jakubprzybytek/ActiveLoad/STM32CubeIDE/ActiveLoadBigMosfets/TouchGFX/generated/fonts/UnicodeListliquidcrystal_20_4.txt

2
32
45
46
48
49
50
51
52
53
54
55
56
57
58
63
65
77
80
102
111
