jakubprzybytek/ActiveLoad/modalBackground.png

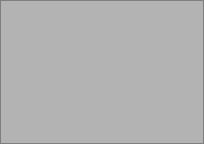
modalBackground.png
