jakubprzybytek/ActiveLoad/Fusion360/pec11r-4x15k-sxxxx.stp

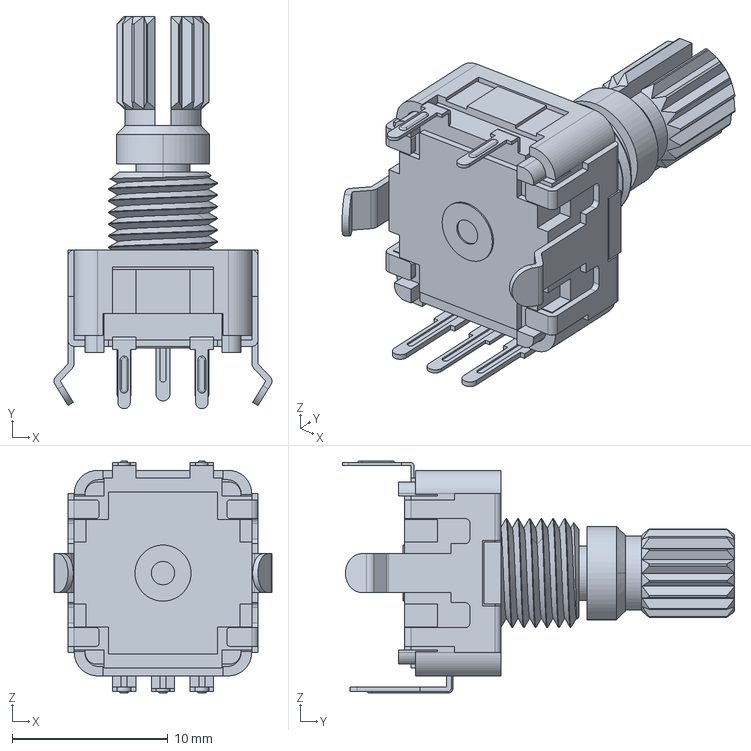
[picture p2: CAD file, 2020-04-10]
Fusion360/pec11r-4x15k-sxxxx.stp
14.0 x 25.2 x 14.9 mm
