jakubprzybytek/ActiveLoad/KiCad/ActiveLoadBigMosfets/ActiveLoadBigMosfets.kicad_pcb

## KiCad design KiCad/ActiveLoadBigMosfets/ActiveLoadBigMosfets.kicad_pcb (2020-07-11)

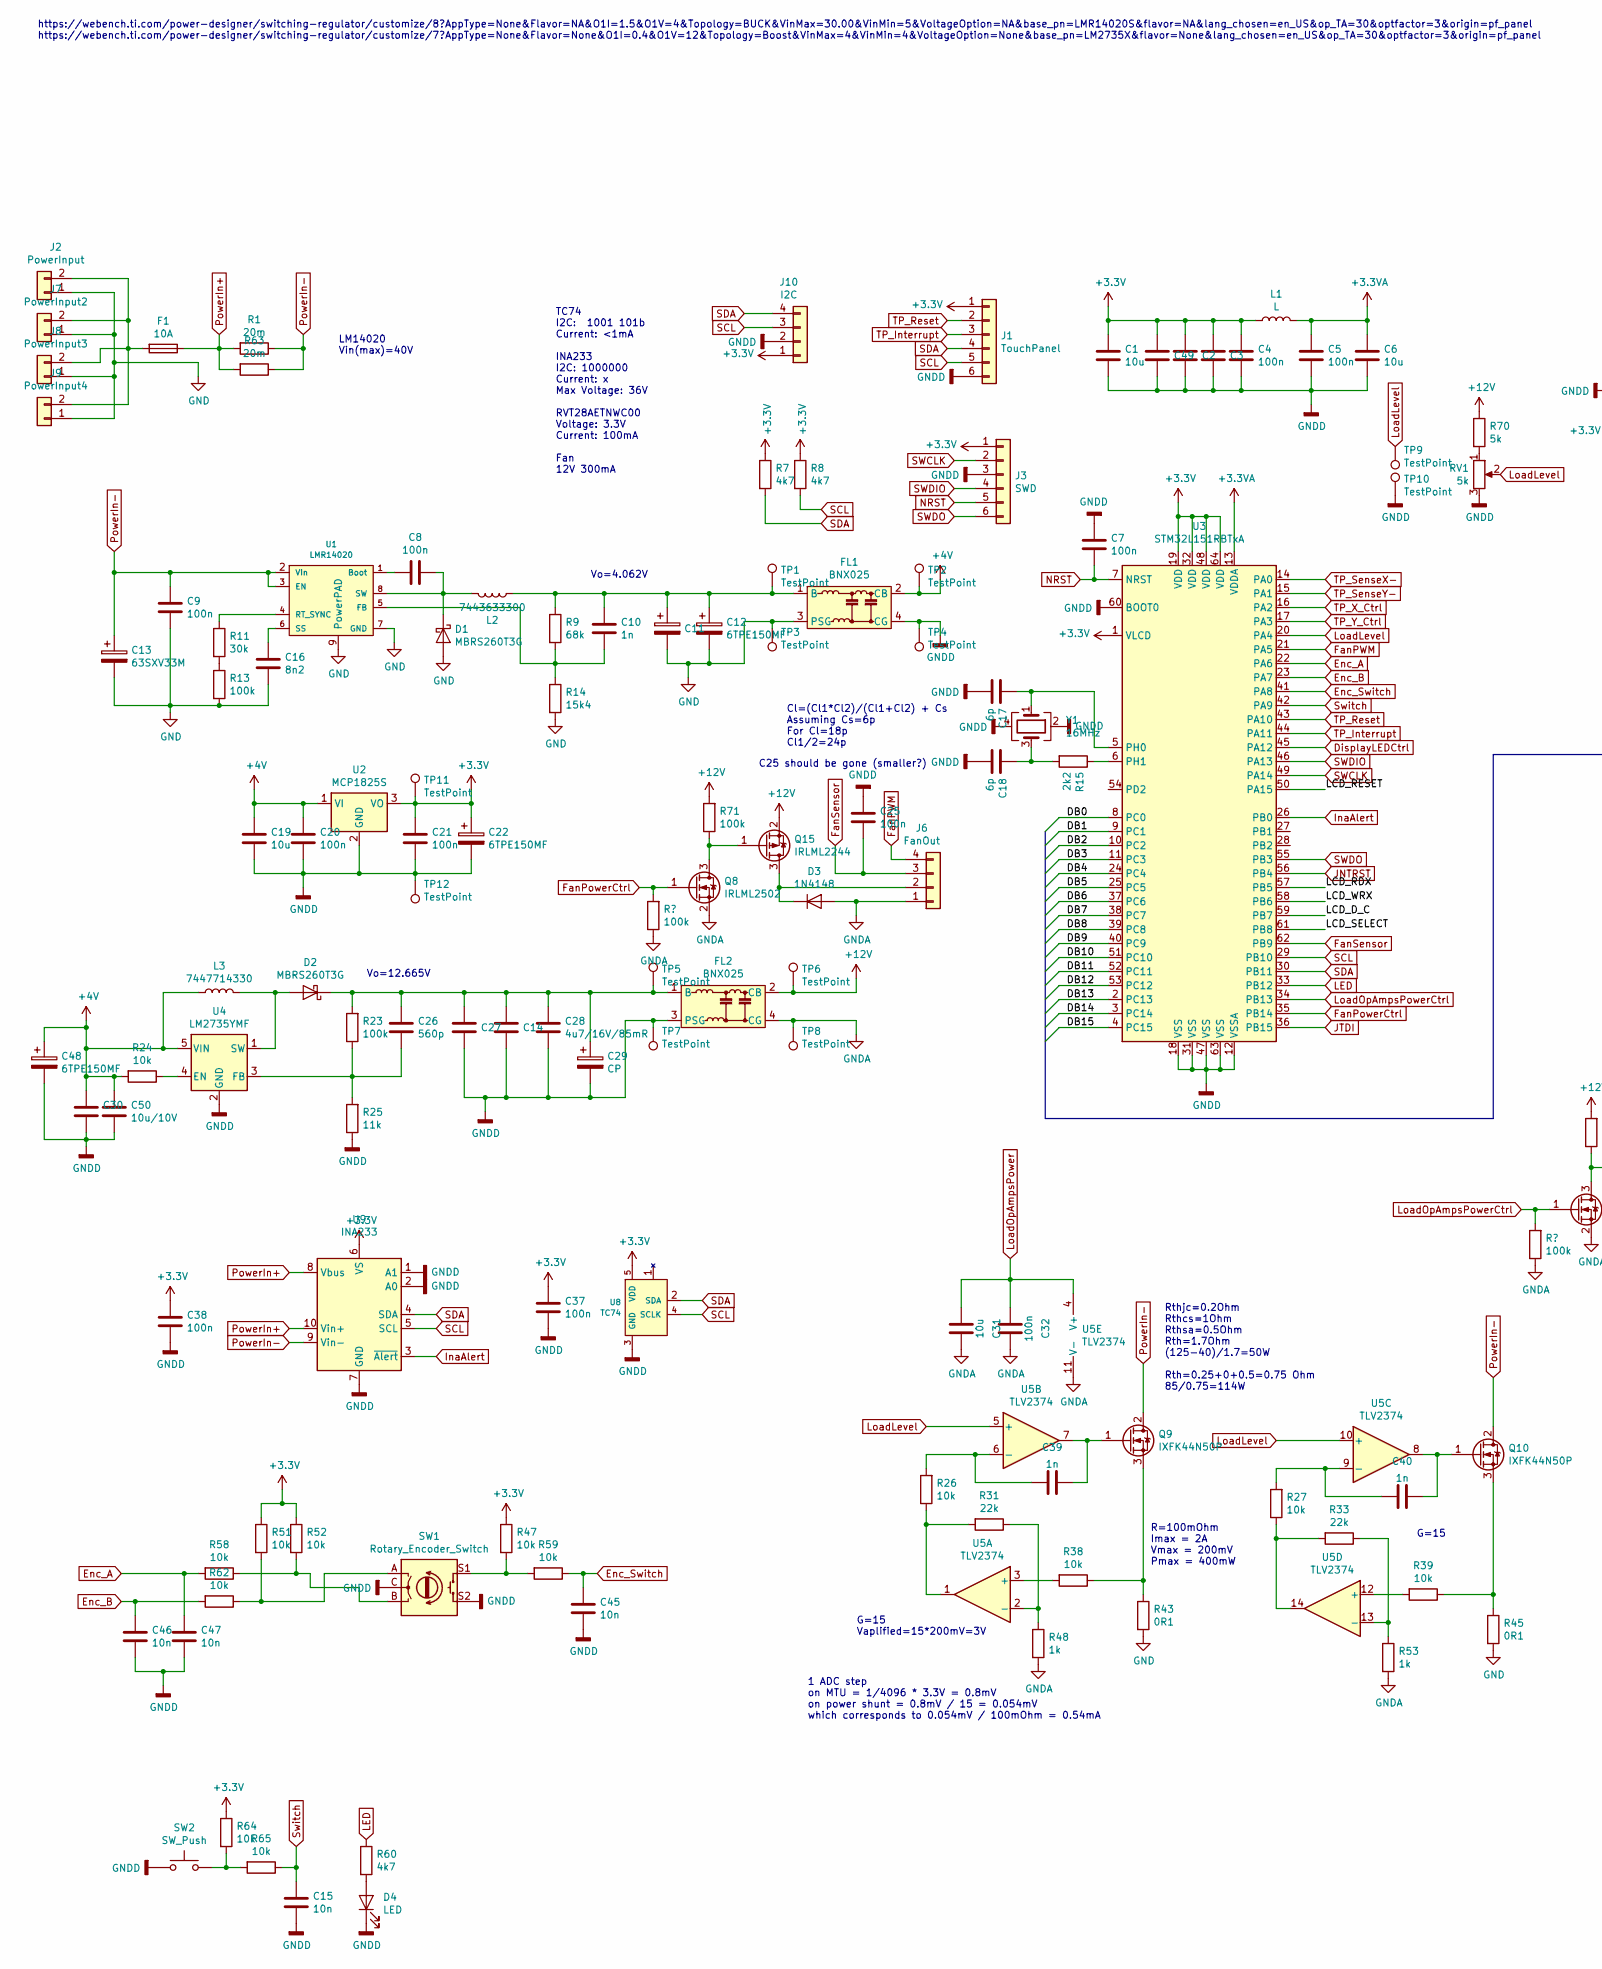
[picture p3: schematic ActiveLoadBigMosfets.sch, part in row 1, column 1]

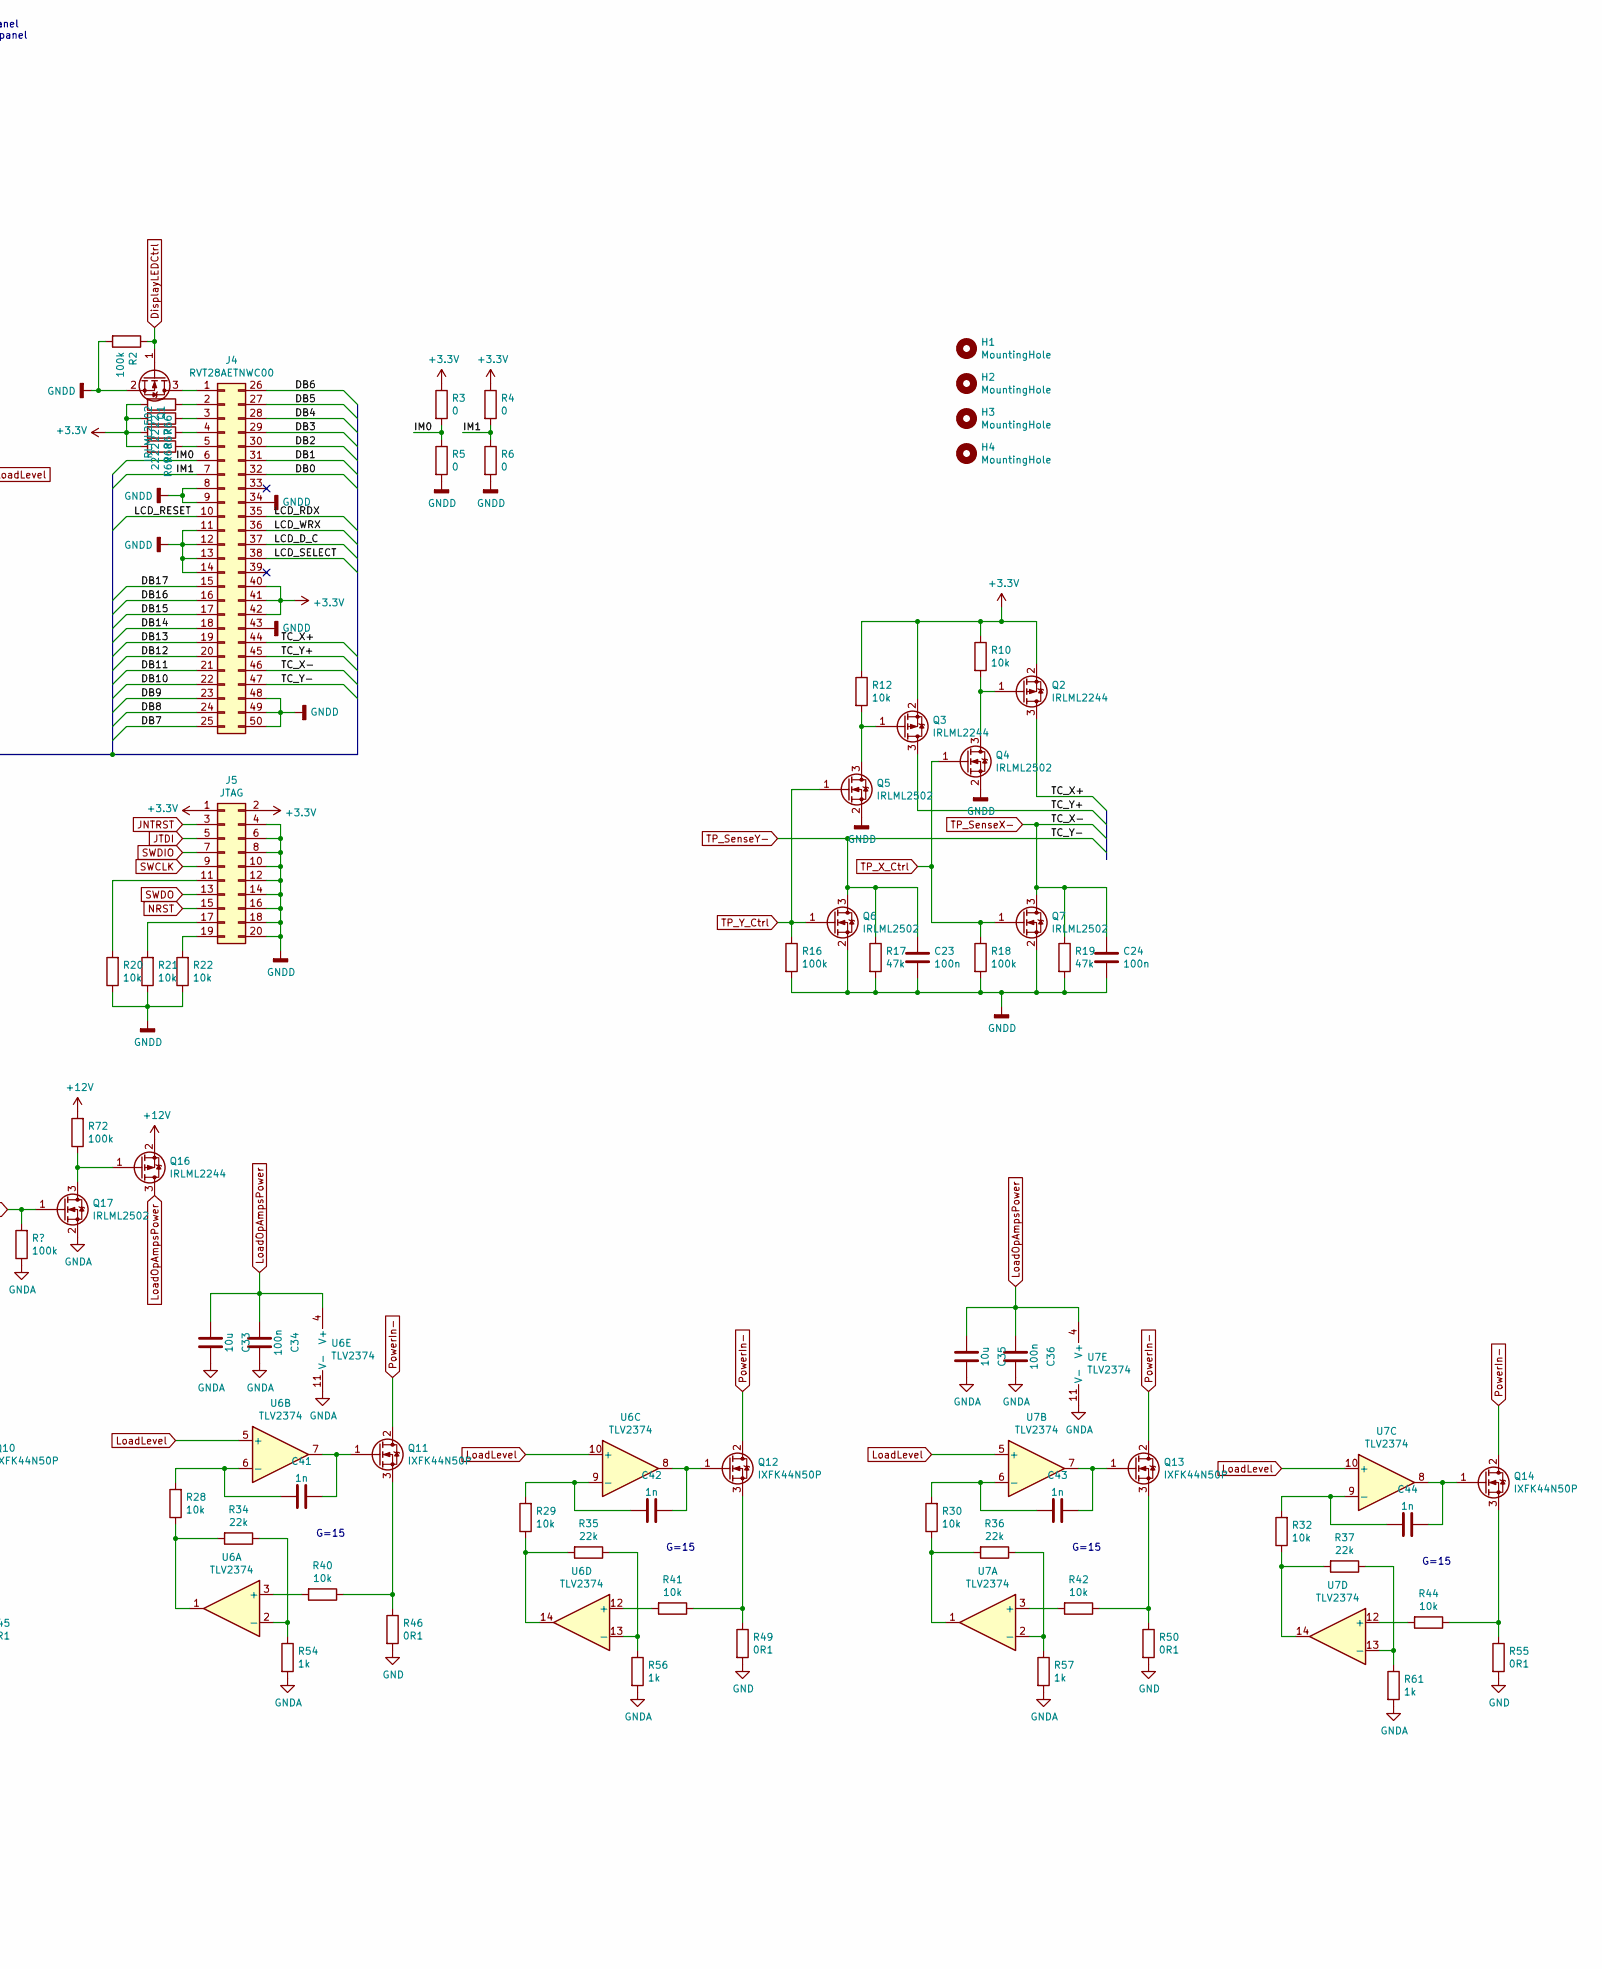
[picture p4: schematic ActiveLoadBigMosfets.sch, part in row 1, column 2]

Parts:
C1, C6, C19, C31, C33, C35: 10u; C_0805_2012Metric
C2, C3, C4, C5, C7, C8, C9, C20, C21, C23, C24, C25, C32, C34, C36, C37, C38, C49: 100n; C_0603_1608Metric
C10, C39, C40, C41, C42, C43, C44: 1n; C_0805_2012Metric
C11, C12, C22, C48: 6TPE150MF; CP_EIA-7343-31_Kemet-D
C13: 63SXV33M; CP_Elec_8x11.9
C14, C27, C28: 4u7/16V/85mR; C_0805_2012Metric
C15, C45, C46, C47: 10n; C_0805_2012Metric
C16: 8n2; C_0805_2012Metric
C17, C18: 6p; C_0805_2012Metric
C26: 560p; C_0805_2012Metric
C29: CP; CP_Elec_6.3x7.7
C30, C50: 10u/10V; C_0805_2012Metric
D1, D2: MBRS260T3G; D_SMB
D3: 1N4148; D_MiniMELF
D4: LED; LED_0805_2012Metric
F1: 10A; Fuseholder5x20_horiz_open_inline_Type-I
FL1, FL2: BNX025; Filter_Murata_BNX025
H1, H2, H3, H4: MountingHole; MountingHole_3.2mm_M3
J1: TouchPanel; TE_0-1734839-6_1x06-1MP_P0.5mm_Horizontal
J2: PowerInput; SolderingHoles-2_P6.00mm_D2.0mm
J3: SWD; PinHeader_1x06_P2.54mm_Vertical
J4: RVT28AETNWC00; Molex-50S-0.5SH_1x50-P0.50mm_Horizontal
J5: JTAG; PinHeader_2x10_P2.54mm_Vertical_SMD
J6: FanOut; FanPinHeader_1x04_P2.54mm_Vertical
J7: PowerInput2; SolderingHoles-2_P6.00mm_D2.0mm
J8: PowerInput3; SolderingHoles-2_P6.00mm_D2.0mm
J9: PowerInput4; SolderingHoles-2_P6.00mm_D2.0mm
J10: I2C; PinHeader_1x04_P2.54mm_Vertical
L1: L; L_0805_2012Metric
L2: 7443633300; L_Wuerth_WE-HCF
L3: 7447714330; L_Wuerth_WE-PDF_Handsoldering
Q1, Q4, Q5, Q6, Q7, Q8, Q17: IRLML2502; SOT-23
Q2, Q3, Q15, Q16: IRLML2244; SOT-23
Q9, Q10, Q11, Q12, Q13, Q14: IXFK44N50P; TO-264-3_Vertical
R1, R63: 20m; R_2512_6332Metric_Pad1.52x3.35mm_HandSolder
R2, R13, R16, R18, R23, R71, R72: 100k; R_0805_2012Metric
R3, R6: 0; SolderJumper-2_P1.3mm_Bridged_RoundedPad1.0x1.5mm
R4, R5: 0; SolderJumper-2_P1.3mm_Open_RoundedPad1.0x1.5mm
R7, R8, R60: 4k7; R_0805_2012Metric
R9: 68k; R_0805_2012Metric
R10, R12, R20, R21, R22, R24, R26, R27, R28, R29, R30, R32, R38, R39, R40, R41, R42, R44, R47, R51, R52, R58, R59, R62, R64, R65: 10k; R_0603_1608Metric
R11: 30k; R_0805_2012Metric
R14: 15k4; R_0805_2012Metric
R15: 2k2; R_0805_2012Metric
R17, R19: 47k; R_0805_2012Metric
R25: 11k; R_0805_2012Metric
R31, R33, R34, R35, R36, R37: 22k; R_0805_2012Metric
R43, R45, R46, R49, R50, R55: 0R1; R_2512_6332Metric_Pad1.52x3.35mm_HandSolder
R48, R53, R54, R56, R57, R61: 1k; R_0805_2012Metric
R66, R67, R68, R69: 22; R_0805_2012Metric
R70: 5k; R_0805_2012Metric
RV1: 5k; Potentiometer_ACP_CA6-VSMD_Vertical
SW1: Rotary_Encoder_Switch; RotaryEncoder_Alps_EC11E-Switch_Vertical_H20mm_CircularMoun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
SW2: SW_Push; SW_SPST_B3S-1000
TP1, TP2, TP3, TP4, TP5, TP6, TP7, TP8, TP9, TP10, TP11, TP12: TestPoint; TestPoint_THTPad_1.5x1.5mm_Drill0.7mm
U1: LMR14020; SOIC-8-1EP_3.9x4.9mm_P1.27mm_EP2.41x3.3mm_ThermalVias
U2: MCP1825S; SOT-223-3_TabPin2
U3: STM32L151RBTxA; LQFP-64_10x10mm_P0.5mm
U4: LM2735YMF; SOT-23-5_HandSoldering
U5, U6, U7: TLV2374; SOIC-14_3.9x8.7mm_P1.27mm
U8: TC74; PinHeader_1x05_P2.54mm_Vertical
U9: INA233; VSSOP-10_3x3mm_P0.5mm
Y1: 16MHz; Crystal_SMD_Abracon_ABM3B-4Pin_5.0x3.2mm

Connections:
+3.3VA: C5.1, C6.1, L1.2, U3.13 (VDDA)
+3V3: C1.1, C2.1, C3.1, C4.1, C21.1, C22.1, C37.1, C38.1, C49.1, J1.1, J3.1, J4.40, J4.41, J4.42, J5.1, J5.2, J10.1, L1.1, Q2.2 (S), Q3.2 (S), R3.1, R4.1, R7.1, R8.1, R10.1, R12.1, R47.1, R51.1, R52.1, R64.1, R66.2, R67.2, R68.2, R69.2, TP11.1, U2.3 (VO), U3.1 (VLCD), U3.19 (VDD), U3.32 (VDD), U3.48 (VDD), U3.64 (VDD), U8.5 (VDD), U9.6 (VS)
+4V: C19.1, C20.1, C30.1, C48.1, C50.1, FL1.2 (CB), L3.1, R24.2, TP2.1, U2.1 (VI), U4.5 (VIN)
+12V: FL2.2 (CB), Q15.2 (S), Q16.2 (S), R70.1, R71.2, R72.2, TP6.1
/DB0: J4.32, U3.8 (PC0)
/DB1: J4.31, U3.9 (PC1)
/DB2: J4.30, U3.10 (PC2)
/DB3: J4.29, U3.11 (PC3)
/DB4: J4.28, U3.24 (PC4)
/DB5: J4.27, U3.25 (PC5)
/DB6: J4.26, U3.37 (PC6)
/DB7: J4.25, U3.38 (PC7)
/DB8: J4.24, U3.39 (PC8)
/DB9: J4.23, U3.40 (PC9)
/DB10: J4.22, U3.51 (PC10)
/DB11: J4.21, U3.52 (PC11)
/DB12: J4.20, U3.53 (PC12)
/DB13: J4.19, U3.2 (PC13)
/DB14: J4.18, U3.3 (PC14)
/DB15: J4.17, U3.4 (PC15)
/DB16: J4.16
/DB17: J4.15
/IM0: J4.6, R3.2, R5.1
/IM1: J4.7, R4.2, R6.1
/LCD_D_C: J4.37, U3.59 (PB7)
/LCD_RDX: J4.35, U3.57 (PB5)
/LCD_RESET: J4.10, U3.50 (PA15)
/LCD_SELECT: J4.38, U3.61 (PB8)
/LCD_WRX: J4.36, U3.58 (PB6)
/TC_X+: J4.44, Q2.3 (D)
/TC_Y+: J4.45, Q3.3 (D)
DisplayLEDCtrl: Q1.1 (G), R2.1, U3.45 (PA12)
Enc_A: C47.1, R58.2, U3.22 (PA6)
Enc_B: C46.1, R62.2, U3.23 (PA7)
Enc_Switch: C45.1, R59.1, U3.41 (PA8)
FanPWM: J6.4, U3.21 (PA5)
FanPowerCtrl: Q8.1 (G), U3.35 (PB14)
FanSensor: C25.2, J6.3, U3.62 (PB9)
GND: C9.2, C11.2, C12.2, C13.2, C16.2, D1.2 (A), FL1.3 (PSG), J2.1, J7.1, J8.1, J9.1, R13.2, R14.2, R43.2, R45.2, R46.2, R49.2, R50.2, R55.2, TP3.1, U1.7 (GND), U1.9 (PowerPAD)
GNDA: C31.2, C32.2, C33.1, C34.2, C35.2, C36.2, D3.2 (A), FL2.4 (CG), J6.1, Q8.2 (S), Q17.2 (S), R48.2, R53.2, R54.2, R56.2, R57.2, R61.2, TP8.1, U5.11 (V-), U6.11 (V-), U7.11 (V-)
GNDD: C1.2, C2.2, C3.2, C4.2, C5.2, C6.2, C7.1, C14.2, C15.2, C17.2, C18.2, C19.2, C20.2, C21.2, C22.2, C23.2, C24.2, C25.1, C27.2, C28.2, C29.2, C30.2, C37.2, C38.2, C45.2, C46.2, C47.2, C48.2, C49.2, C50.2, D4.1 (K), FL1.4 (CG), FL2.3 (PSG), J1.6, J3.3, J4.8, J4.9, J4.11, J4.12, J4.13, J4.14, J4.34, J4.43, J4.48, J4.49, J4.50, J5.4, J5.6, J5.8, J5.10, J5.12, J5.14, J5.16, J5.18, J5.20, J10.2, Q1.2 (S), Q4.2 (S), Q5.2 (S), Q6.2 (S), Q7.2 (S), R2.2, R5.2, R6.2, R16.2, R17.2, R18.2, R19.2, R20.1, R21.1, R22.1, R25.1, RV1.3, SW1.C, SW1.S2, SW2.1, TP4.1, TP7.1, TP10.1, TP12.1, U2.2 (GND), U3.12 (VSSA), U3.18 (VSS), U3.31 (VSS), U3.47 (VSS), U3.60 (BOOT0), U3.63 (VSS), U4.2 (GND), U8.3 (GND), U9.1 (A1), U9.2 (A0), U9.7 (GND), Y1.2, Y1.4
InaAlert: U3.26 (PB0), U9.3 (~Alert~)
JNTRST: J5.3, U3.56 (PB4)
JTDI: J5.5, U3.36 (PB15)
LED: R60.1, U3.33 (PB12)
LoadLevel: RV1.2, TP9.1, U3.20 (PA4), U5.5 (+), U5.10 (+), U6.5 (+), U6.10 (+), U7.5 (+), U7.10 (+)
LoadOpAmpsPower: C31.1, C32.1, C33.2, C34.1, C35.1, C36.1, Q16.3 (D), U5.4 (V+), U6.4 (V+), U7.4 (V+)
LoadOpAmpsPowerCtrl: Q17.1 (G), U3.34 (PB13)
NRST: C7.2, J3.5, J5.15, U3.7 (NRST)
unnamed: C8.1, D1.1 (K), L2.2, U1.8 (SW)
unnamed: C8.2, U1.1 (Boot)
unnamed: C10.1, C11.1, C12.1, FL1.1 (B), L2.1, R9.1, TP1.1
unnamed: C10.2, R9.2, R14.1, U1.5 (FB)
unnamed: C14.1, C26.1, C27.1, C28.1, C29.1, D2.1 (K), FL2.1 (B), R23.2, TP5.1
unnamed: C16.1, U1.6 (SS)
unnamed: C17.1, U3.5 (PH0), Y1.1
unnamed: C18.1, R15.2, Y1.3
unnamed: C26.2, R23.1, R25.2, U4.3 (FB)
unnamed: C39.1, R26.2, U5.6 (-)
unnamed: C39.2, Q9.1 (G), U5.7
unnamed: C40.1, R27.2, U5.9 (-)
unnamed: C40.2, Q10.1 (G), U5.8
unnamed: C41.1, R28.2, U6.6 (-)
unnamed: C41.2, Q11.1 (G), U6.7
unnamed: C42.1, R29.2, U6.9 (-)
unnamed: C42.2, Q12.1 (G), U6.8
unnamed: C43.1, R30.2, U7.6 (-)
unnamed: C43.2, Q13.1 (G), U7.7
unnamed: C44.1, R32.2, U7.9 (-)
unnamed: C44.2, Q14.1 (G), U7.8
unnamed: D2.2 (A), L3.2, U4.1 (SW)
unnamed: D3.1 (K), J6.2, Q15.3 (D)
unnamed: D4.2 (A), R60.2
unnamed: F1.2, J2.2, J7.2, J8.2, J9.2
unnamed: J4.1, Q1.3 (D)
unnamed: J4.2, R66.1
unnamed: J4.3, R67.1
unnamed: J4.4, R68.1
unnamed: J4.5, R69.1
unnamed: J5.11, R20.2
unnamed: J5.17, R21.2
unnamed: J5.19, R22.2
unnamed: Q2.1 (G), Q4.3 (D), R10.2
unnamed: Q3.1 (G), Q5.3 (D), R12.2
unnamed: Q9.3 (S), R38.1, R43.1
unnamed: Q10.3 (S), R39.1, R45.1
unnamed: Q11.3 (S), R40.1, R46.1
unnamed: Q12.3 (S), R41.1, R49.1
unnamed: Q13.3 (S), R42.1, R50.1
unnamed: Q14.3 (S), R44.1, R55.1
unnamed: Q8.3 (D), Q15.1 (G), R71.1
unnamed: Q16.1 (G), Q17.3 (D), R72.1
unnamed: R11.1, U1.4 (RT_SYNC)
unnamed: R11.2, R13.1
unnamed: R15.1, U3.6 (PH1)
unnamed: R24.1, U4.4 (EN)
unnamed: R26.1, R31.2, U5.1
unnamed: R27.1, R33.2, U5.14
unnamed: R28.1, R34.2, U6.1
unnamed: R29.1, R35.2, U6.14
unnamed: R30.1, R36.2, U7.1
unnamed: R31.1, R48.1, U5.2 (-)
unnamed: R32.1, R37.2, U7.14
unnamed: R33.1, R53.1, U5.13 (-)
unnamed: R34.1, R54.1, U6.2 (-)
unnamed: R35.1, R56.1, U6.13 (-)
unnamed: R36.1, R57.1, U7.2 (-)
unnamed: R37.1, R61.1, U7.13 (-)
unnamed: R38.2, U5.3 (+)
unnamed: R39.2, U5.12 (+)
unnamed: R40.2, U6.3 (+)
unnamed: R41.2, U6.12 (+)
unnamed: R42.2, U7.3 (+)
unnamed: R44.2, U7.12 (+)
unnamed: R47.2, R59.2, SW1.S1
unnamed: R51.2, R62.1, SW1.A
unnamed: R52.2, R58.1, SW1.B
unnamed: R64.2, R65.2, SW2.2
unnamed: R70.2, RV1.1
PowerIn+: F1.1, R1.2, R63.2, U9.8 (Vbus), U9.10 (Vin+)
PowerIn-: C9.1, C13.1, Q9.2 (D), Q10.2 (D), Q11.2 (D), Q12.2 (D), Q13.2 (D), Q14.2 (D), R1.1, R63.1, U1.2 (Vin), U1.3 (EN), U9.9 (Vin-)
SCL: J1.5, J10.3, R8.2, U3.29 (PB10), U8.4 (SCLK), U9.5 (SCL)
SDA: J1.4, J10.4, R7.2, U3.30 (PB11), U8.2 (SDA), U9.4 (SDA)
SWCLK: J3.2, J5.9, U3.49 (PA14)
SWDIO: J3.4, J5.7, U3.46 (PA13)
SWDO: J3.6, J5.13, U3.55 (PB3)
Switch: C15.1, R65.1, U3.42 (PA9)
TP_Interrupt: J1.3, U3.44 (PA11)
TP_Reset: J1.2, U3.43 (PA10)
TP_SenseX-: C24.1, J4.46, Q7.3 (D), R19.1, U3.14 (PA0)
TP_SenseY-: C23.1, J4.47, Q6.3 (D), R17.1, U3.15 (PA1)
TP_X_Ctrl: Q4.1 (G), Q7.1 (G), R18.1, U3.16 (PA2)
TP_Y_Ctrl: Q5.1 (G), Q6.1 (G), R16.1, U3.17 (PA3)

Notes on the sheet:
LM14020 Vin(max)=40V
TC74 I2C: 1001 101b Current: <1mA INA233 I2C: 1000000 Current: x Max Voltage: 36V RVT28AETNWC00 Voltage: 3.3V Current: 100mA Fan 12V 300mA
https://webench.ti.com/power-designer/switching-regulator/customize/8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 https://webench.ti.com/power-designer/switching-regulato…
R=100mOhm Imax = 2A Vmax = 200mV Pmax = 400mW
Rthjc=0.2Ohm Rthcs=1Ohm Rthsa=0.5Ohm Rth=1.7Ohm (125-40)/1.7=50W Rth=0.25+0+0.5=0.75 Ohm 85/0.75=114W
G=15 Vaplified=15*200mV=3V
G=15
Vo=4.062V
Vo=12.665V
1 ADC step on MTU = 1/4096 * 3.3V = 0.8mV on power shunt = 0.8mV / 15 = 0.054mV which corresponds to 0.054mV / 100mOhm = 0.54mA
Cl=(Cl1*Cl2)/(Cl1+Cl2) + Cs Assuming Cs=6p For Cl=18p Cl1/2=24p
C25 should be gone (smaller?)

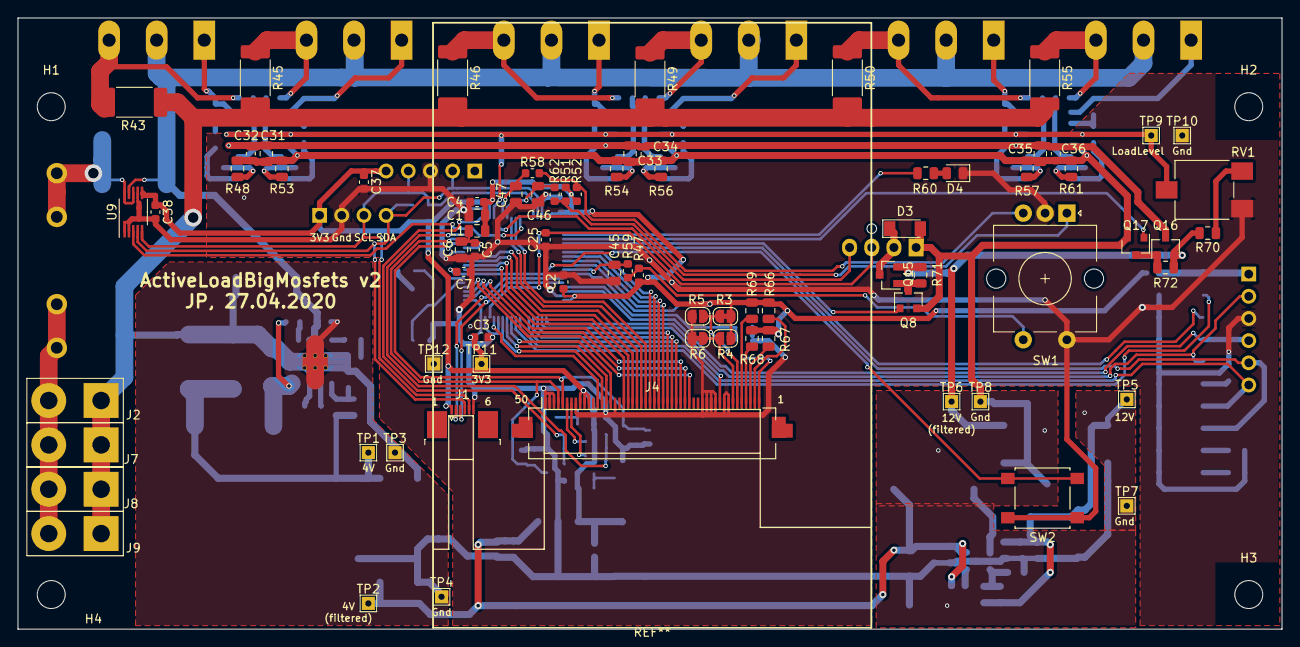
[picture p5: board ActiveLoadBigMosfets.kicad_pcb from above]

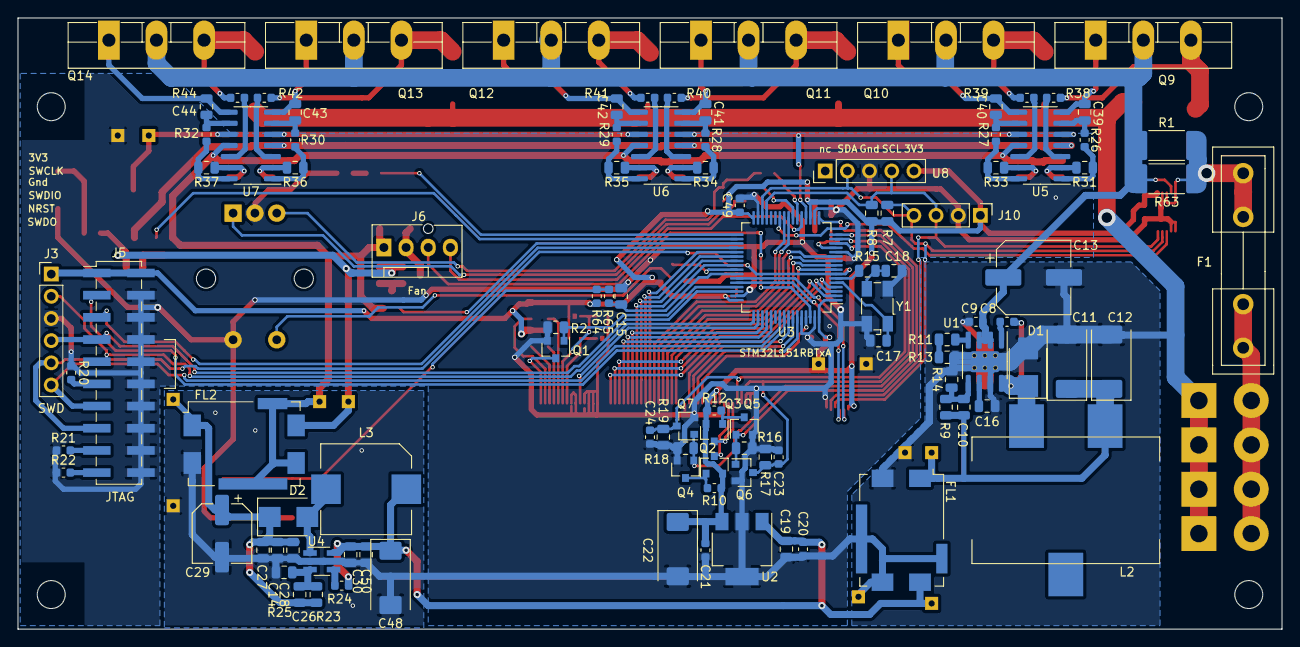
[picture p6: board ActiveLoadBigMosfets.kicad_pcb from below]

Board: 2 copper layers, 144.8 x 70.0 mm, 188 parts (106 on the bottom side), 131 nets.
