jakubprzybytek/ActiveLoad/KiCad/ActiveLoadMosfets/ActiveLoadMosfets.kicad_pcb

## KiCad design KiCad/ActiveLoadMosfets/ActiveLoadMosfets.kicad_pcb (2018-09-21)

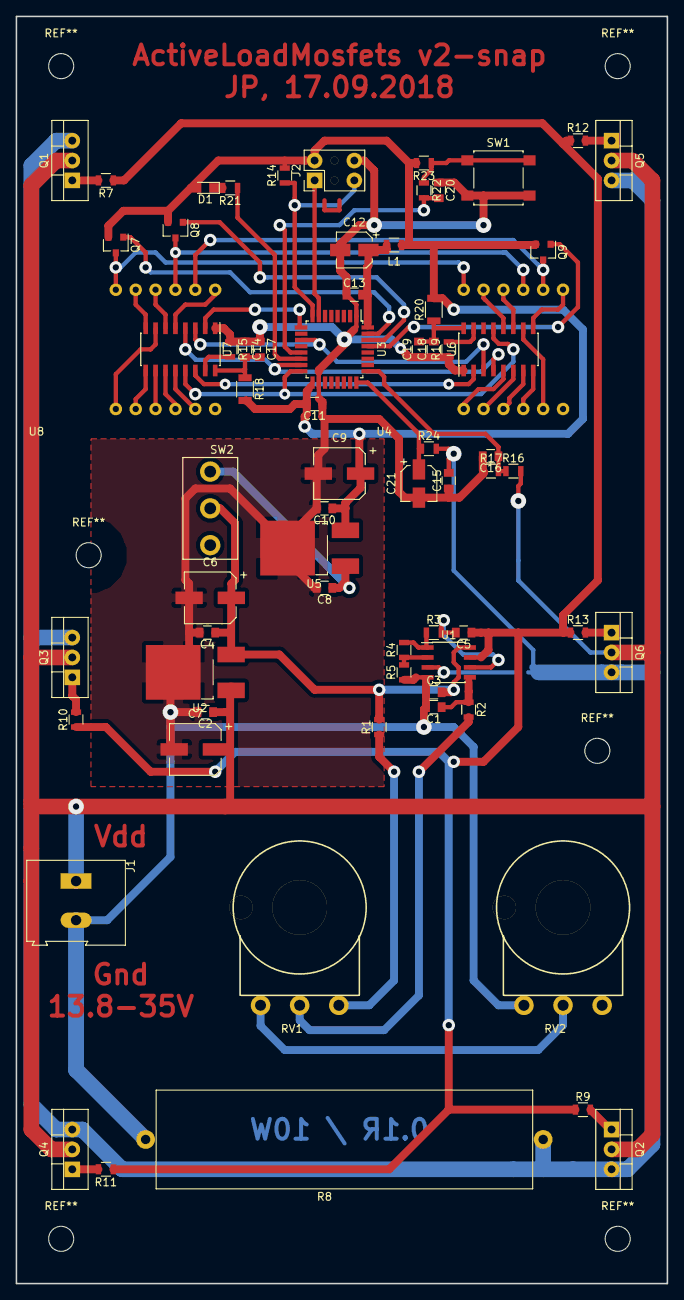
[picture p7: board ActiveLoadMosfets.kicad_pcb from above]

Board: 2 copper layers, 83.2 x 161.9 mm, 70 parts (1 on the bottom side), 61 nets.

Parts:
C1: 220n; C_0805
C2: 470n; C_0805
C3, C4, C8, C10, C11, C13, C15, C16: 100n; C_0805
C5: 1n; C_0805
C6, C7, C9: 47u; CP_Elec_6.3x5.8
C12, C21: 10u; CP_Elec_4x5.8
C14, C19, C20: 10n; C_0805
C17, C18: 1u; C_0805
D1: LED; LED_0805
J1: Conn_01x02_Male; TerminalBlock_Altech_AK300-2_P5.00mm
J2: Conn_02x03_Odd_Even; Pin_Header_Straight_2x03_Pitch2.54mm
L1: 10u; L_0805
Q1: STP60NF06L / STP9NK60Z; TO-220-3_Vertical
Q2, Q3, Q4, Q5, Q6: STP60NF06L; TO-220-3_Vertical
Q7, Q8, Q9: IRLML2244; SOT-23
R1, R16: 47k; R_0805
R2: 5k; R_0805
R3, R14, R21, R22, R23: 10k; R_0805
R4: 6k8; R_0805
R5, R6: 1k; R_0805
R7, R9, R10, R11, R12, R13: 51; R_0805
R8: 0R1; R_Axial_Power_L48.0mm_W12.5mm_P50.8mm
R15, R19: 15k; R_0805
R17, R24: 1k1; R_0805
R18, R20: 10; R_1206
RV1: 47k; Pot_PCB-mount
RV2: 1k; Pot_PCB-mount
SW1: SW_SPST; SW_SPST_B3S-1000
SW2: SW_SPDT; SlideSwitch3Poles
U1: TLV2372; SOIC-8_3.9x4.9mm_Pitch1.27mm
U2: LM78M09; TO-252-2_Rectifier
U3: ATxmega32E5-AU; TQFP-32_7x7mm_Pitch0.8mm
U4, U8: LED-3digits; LED-14.2x3
U5: LM78M33; TO-252-2_Rectifier
U6, U7: SCT2167; SOIC-16_3.9x9.9mm_Pitch1.27mm

Connections:
+3V3: C9.1, C10.1, C11.2, D1.2, J2.2, L1.1, Q7.2, Q8.2, Q9.2, R14.2, R18.2, R20.2, R23.2, U3.17, U5.3
+12V: C3.2, C4.1, C6.1, R1.2, SW2.2, U1.8, U2.3
/+3.3Va: C12.1, C13.2, L1.2, U3.32
CURRENT: C21.1, R24.1, U3.24
Digit1: Q7.1, U3.31
Digit2: Q8.1, U3.30
Digit3: Q9.1, U3.29
GND: C1.2, C2.2, C3.1, C4.2, C6.2, C7.2, C8.2, C9.2, C10.2, C11.1, C12.2, C13.1, C14.1, C15.1, C16.2, C17.1, C18.1, C19.1, C20.1, C21.2, J1.2, J2.6, R5.1, R8.2, R15.1, R17.1, R19.1, RV2.1, SW1.2, U1.4, U2.2, U3.1, U3.18, U5.2, U6.1, U7.1
LED: R21.1, U3.14
Latch: U3.15, U6.4, U7.4
MOSI: U3.9, U7.2
unnamed: C1.1, R2.1, U1.5
unnamed: C5.1, R7.1, R9.1, R10.1, R11.1, R12.1, R13.1, U1.7
unnamed: C5.2, R3.2, U1.6
unnamed: C8.1, SW2.3, U5.1
unnamed: C14.2, C17.2, R18.1, U7.16
unnamed: C15.2, Q1.3, Q2.3, Q3.3, Q4.3, Q5.3, Q6.3, R6.1, R8.1, R24.2
unnamed: C18.2, C19.2, R20.1, U6.16
unnamed: D1.1, R21.2
unnamed: Q1.1, R7.2
unnamed: Q2.1, R9.2
unnamed: Q3.1, R10.2
unnamed: Q4.1, R11.2
unnamed: Q5.1, R12.2
unnamed: Q6.1, R13.2
unnamed: Q7.3, U4.12, U8.12
unnamed: Q8.3, U4.9, U8.9
unnamed: Q9.3, U4.8, U8.8
unnamed: R1.1, RV1.3
unnamed: R2.2, RV1.2
unnamed: R3.1, R4.2, U1.1
unnamed: R4.1, R5.2, U1.2
unnamed: R6.2, U1.3
unnamed: R15.2, U7.15
unnamed: R19.2, U6.15
unnamed: R22.1, R23.1, SW1.1
unnamed: RV1.1, RV2.2
unnamed: U4.1, U6.5
unnamed: U4.2, U6.6
unnamed: U4.3, U6.7
unnamed: U4.4, U6.8
unnamed: U4.5, U6.10
unnamed: U4.7, U6.9
unnamed: U4.10, U6.11
unnamed: U4.11, U6.12
unnamed: U6.2, U7.14
unnamed: U7.5, U8.7
unnamed: U7.6, U8.10
unnamed: U7.7, U8.1
unnamed: U7.8, U8.11
unnamed: U7.9, U8.2
unnamed: U7.10, U8.3
unnamed: U7.11, U8.4
unnamed: U7.12, U8.5
OutputEnabled: U3.16, U6.13, U7.13
PDI_CLK: J2.5, R14.1, U3.8
PDI_DATA: J2.1, U3.7
SCK: U3.11, U6.3, U7.3
SWITCH: C20.2, R22.2, U3.13
VDD: C2.1, C7.1, J1.1, Q1.2, Q2.2, Q3.2, Q4.2, Q5.2, Q6.2, R16.2, U2.1
VOLTAGE: C16.1, R16.1, R17.2, U3.25
