jakubprzybytek/ActiveLoad/KiCad/ActiveLoad/ActiveLoad.kicad_pcb

## KiCad design KiCad/ActiveLoad/ActiveLoad.kicad_pcb (2018-05-13)

Schematic: ActiveLoad.sch

Parts:
C2, C5, C8, C10, C15, C17: 100n; C_0805
C3: 47u; CP_Elec_6.3x5.8
C4, C9: 100u; CP_Elec_6.3x7.7
C6, C11: 10u; CP_Elec_3x5.3
C7, C12, C13: 10n; C_0805
C14, C16: 1u; C_0805
C18: 200u; CP_Elec_6.3x7.7
D1, D2: 1N4148; SMD-1206_Pol
D3: BYS10-45; D_SMA
D4: LED; D_0805
J1: AuxPower; PowerSocketSMD
J2: OLED I2C; OLED_0.96inch_128x64_I2C
J3: PDI; Pin_Header_Angled_2x03_Pitch2.54mm
J4: TC74X-3.3; TO-220-5_Vertical
J5: PowerInput; PowerSocketSMD
J6: FAN; Pin_Header_Angled_1x03_Pitch2.54mm
L1: 10u; R_0805
Q2: BC817; SOT-23
Q3: BD911; TO-220-3_Vertical
Q4: BD140; TO-126_Vertical
R1, R2, R16: 2k2; R_0805
R3, R4, R5, R6, R7, R8, R9, R10, R12, R19: 10k; R_0805
R11, R15: 15k42; R_0805
R13, R25: 3k3; R_0805
R14, R17, R18, R23, R26: 1k; R_0805
R20: 0R1; R_Axial_Power_L48.0mm_W12.5mm_P50.8mm
R21: 680; R_0805
R22: 120k; R_0805
R24: 100k; R_0805
ROT1: ROTARY-ENCODER; SF-ROTARY-ENCODER
SW1, SW2: SW_SPDT; SlideSwitch3Poles
U1: UA78M33; TO-252-2_Rectifier
U2: L78M12; TO-252-2_Rectifier
U3: ATXMEGA32E5-AU; TQFP-32_7x7mm_Pitch0.8mm
U4: OPA2170; SOIC-8_3.9x4.9mm_Pitch1.27mm
U5: LM7321; SOIC-8_3.9x4.9mm_Pitch1.27mm

Connections:
+3V3: C2.1, C3.1, C5.2, C6.1, D4.2, J2.1, J3.2, J4.5, L1.1, R1.2, R2.2, R4.2, R6.2, R7.2, R8.2, U1.3 (OUT), U3.17 (VCC)
+12V: C8.1, C9.1, C15.2, C17.2, D3.1, Q4.1 (E), R21.2, R26.2, SW2.1, U4.8 (V+), U5.7 (V+)
CURRENT_LEVEL: Q3.3, R17.1, R20.1, U3.29 (AC0OUT/AC7/ADC7/PA7)
DRAIN_CONTROL: R11.1, U3.3 (DAC1/AC3/ADC3/PA3)
ENC_A: C12.1, R9.1, U3.11 (IN2/SCK/XCK0/OC5B/OC4CHS/OC4B/PC5)
ENC_B: C13.1, R10.1, U3.12 (EXTCLK/OUT0/IN1/~SS~/OC5A/~OC4CLS~/OC4A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)
ENC_Switch: C7.2, R5.2, U3.9 (AC0OUT/IN3/MOSI/TXD0/OC4DHS/OC4D/PC7)
FAN_CONTROL: R15.1, U3.4 (DAC0/AC2/ADC2/PA2)
GND: C2.2, C3.2, C4.2, C5.1, C6.2, C7.1, C8.2, C9.2, C10.2, C11.2, C12.2, C13.2, C14.2, C15.1, C16.2, C17.1, C18.2, D1.2, D2.1, J1.1, J2.2, J3.6, J4.3, J5.1, J6.3, Q2.2, R14.1, R18.1, R19.1, R20.2, R25.1, ROT1.3, ROT1.5, U1.2 (GND), U3.1 (GND), U3.18 (GND), U4.4 (V-), U5.4 (V-)
LED: R3.2, U3.25 (PD3/ADC11/TXD0/IN3/OC1)
unnamed: C4.1, SW1.2, SW2.2, U1.1 (IN)
unnamed: C10.1, C11.1, L1.2, U3.32 (AVCC)
unnamed: C14.1, R11.2, U4.6 (-)
unnamed: C16.1, R15.2, U5.2 (-)
unnamed: C18.1, D1.1, J6.2, Q4.2 (C), R22.2
unnamed: D2.2, U2.2 (GND)
unnamed: D3.2, U2.3 (OUT)
unnamed: D4.1, R3.1
unnamed: J1.2, SW1.3
unnamed: Q2.1, R16.1, R18.2
unnamed: Q2.3, Q3.1, R21.1
unnamed: Q4.3 (B), R23.2, R26.1
unnamed: R5.1, R6.1, ROT1.1
unnamed: R7.1, R9.2, ROT1.2
unnamed: R8.1, R10.2, ROT1.4
unnamed: R12.1, R13.1, U4.1
unnamed: R12.2, U4.5 (+)
unnamed: R13.2, R14.2, U4.2 (-)
unnamed: R16.2, U4.7
unnamed: R17.2, U4.3 (+)
unnamed: R19.2, R22.1, U5.3 (+)
unnamed: R23.1, U5.6
unnamed: SW2.3, U2.1 (IN)
PDI_CLK: J3.5, R4.1, U3.8 (~RESET~/PDI_CLK)
PDI_DATA: J3.1, U3.7 (PDI_DATA)
PowerInput: J5.2, Q3.2, R24.2, SW1.1
SCK: J2.3, J4.4, R2.1, U3.15 (IN2/SCL/XCK0/OC4AHS/OC4B/PC1)
SDA: J2.4, J4.2, R1.1, U3.16 (OUT0/IN1/SDA/~OC4ALS~/OC4A/PC0)
VOLTAGE_LEVEL: R24.1, R25.2, U3.30 (AC1OUT/AC6/ADC6/PA6)

Notes on the sheet:
32E5 (1.2mA) Display 0111 100 (80mW, 25mA) TC74 1001 xxx (0.3mA) Rot (1mA) LM358 (2mA) 1. NC 2. SDA 3. GND 4. SCK 5. VDD
Fan Control: 0-1V Fan Voltage: 0-12V G=1V/12V=12 R19/(R12+R22)=1/13
G=1/30 Voltage 0-30
Input Current 0-10A Current Level 0-1V
G=3
Max Voltage L78M12 - 35V UA78M33 - 25V OPA2170 - 36V LM7321 - 32V
Iq2=22mA
Collector to case

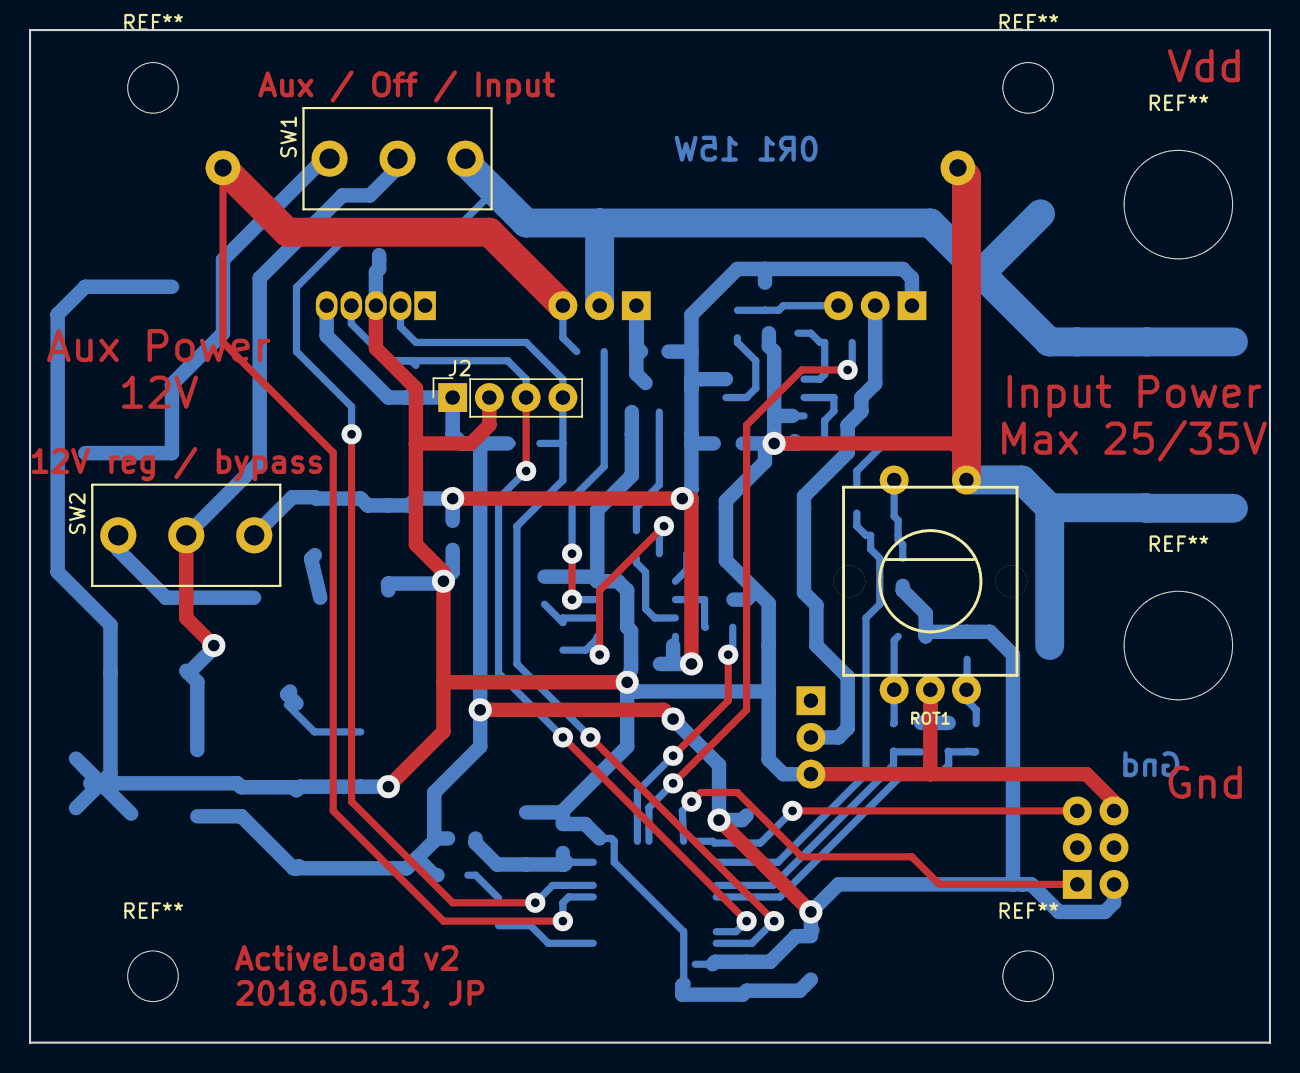
[picture p8: board ActiveLoad.kicad_pcb from above]

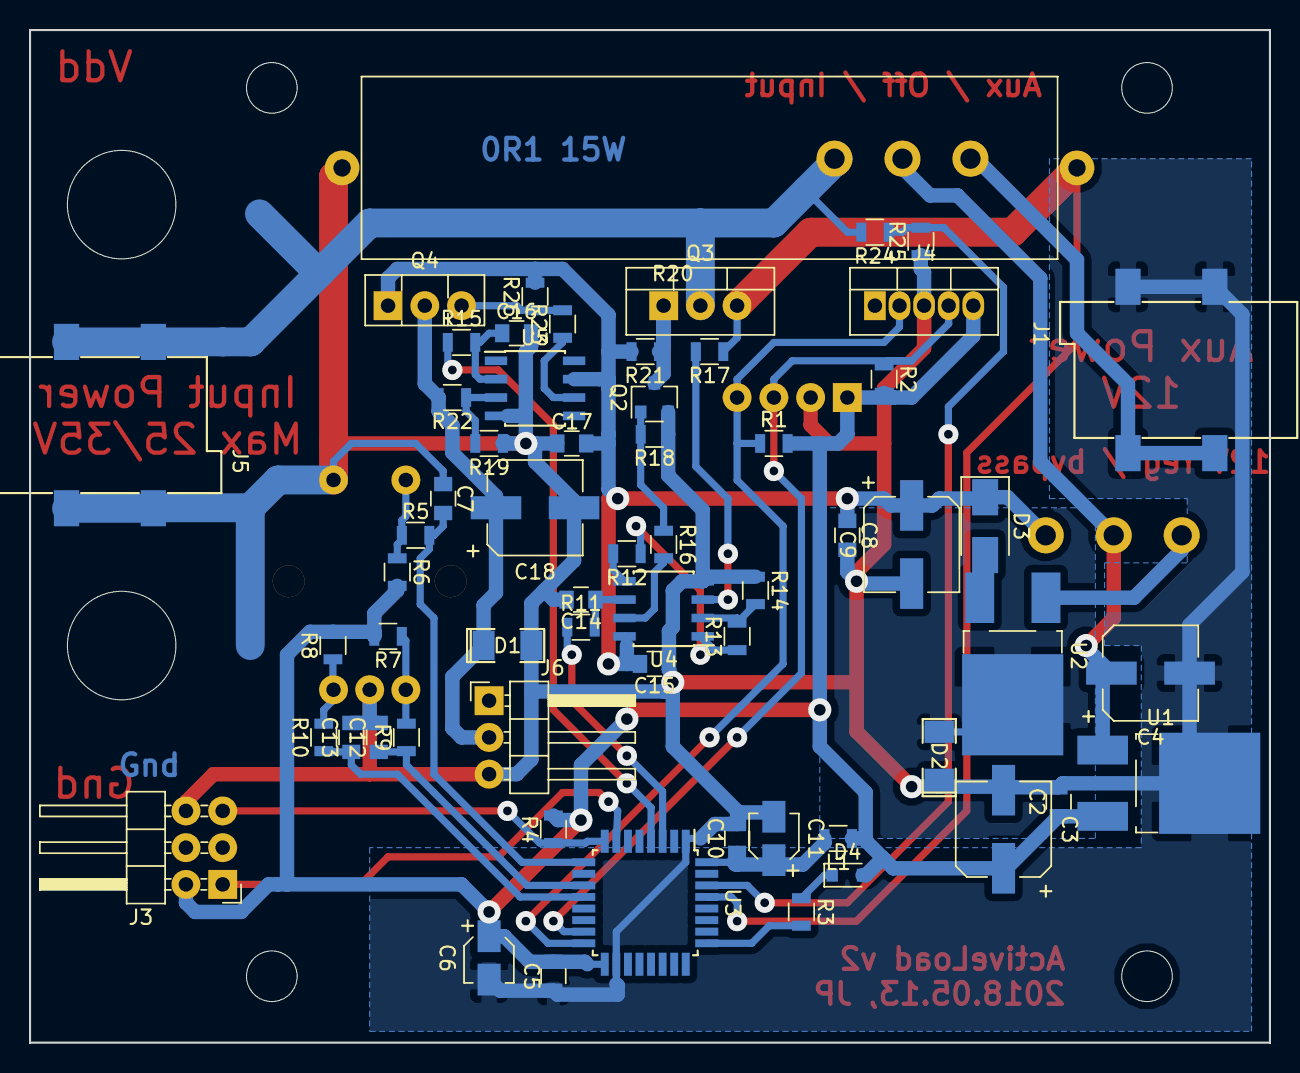
[picture p9: board ActiveLoad.kicad_pcb from below]

Board: 2 copper layers, 85.7 x 70.0 mm, 65 parts (61 on the bottom side), 39 nets.
