jakubprzybytek/ActiveLoad/STM32CubeIDE/ActiveLoadBigMosfets/Core/Src/main.cpp

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

/* Includes ------------------------------------------------------------------*/
#include "main.h"

/* USER CODE BEGIN Includes */
#include <touchgfx/hal/OSWrappers.hpp>
#include "app_touchgfx.h"

#include "stdio.h"
#include "ApplicationState.hpp"
#include "FanController.hpp"

#include "devices/INA233.hpp"
#include "devices/TC74.hpp"
#include "devices/RVT28AETNWC00.hpp"
/* USER CODE END Includes */

CRC_HandleTypeDef hcrc;

DAC_HandleTypeDef hdac;

I2C_HandleTypeDef hi2c2;

RTC_HandleTypeDef hrtc;

TIM_HandleTypeDef htim2;
TIM_HandleTypeDef htim3;

/* USER CODE BEGIN PV */

ApplicationState applicationState;
FanController fanController(&htim2);

INA233 ina233(&hi2c2);
TC74 tc74(&hi2c2);
RVT28AETNWC00 display;

/* USER CODE END PV */

void SystemClock_Config(void);
static void MX_GPIO_Init(void);
static void MX_I2C2_Init(void);
static void MX_TIM3_Init(void);
static void MX_DAC_Init(void);
static void MX_RTC_Init(void);
static void MX_TIM2_Init(void);
static void MX_CRC_Init(void);
/**
  * @brief  The application entry point.
  * @retval int
  */
int main(void)
{
  /* MCU Configuration--------------------------------------------------------*/

  /* Reset of all peripherals, Initializes the Flash interface and the Systick. */
  HAL_Init();

  /* Configure the system clock */
  SystemClock_Config();

  /* Initialize all configured peripherals */
  MX_GPIO_Init();
  MX_I2C2_Init();
  MX_TIM3_Init();
  MX_DAC_Init();
  MX_RTC_Init();
  MX_TIM2_Init();
  MX_CRC_Init();
  /* USER CODE BEGIN 2 */

  fanController.setSpeed(0);

  MX_TouchGFX_Init();

  HAL_DAC_Start(&hdac,DAC_CHANNEL_1);
  HAL_DAC_SetValue(&hdac,DAC_CHANNEL_1,DAC_ALIGN_12B_R,0);


  HAL_GPIO_WritePin(GPIOB, GPIO_PIN_12, GPIO_PIN_SET);

  display.init();
  HAL_GPIO_WritePin(Display_LED_Ctrl_GPIO_Port, Display_LED_Ctrl_Pin, GPIO_PIN_SET);

  HAL_TIM_Encoder_Start(&htim3, TIM_CHANNEL_ALL);

  ina233.init();

  /* USER CODE END 2 */

  /* Infinite loop */
  /* USER CODE BEGIN WHILE */
  while (1)
  {
    /* USER CODE END WHILE */

    /* USER CODE BEGIN 3 */
	  touchgfx::OSWrappers::signalVSync();
	  MX_TouchGFX_Process();

	  HAL_GPIO_TogglePin(LED_GPIO_Port, LED_Pin);

	  applicationState.voltage = ina233.readVoltage();
	  applicationState.current = ina233.readCurrent();

	  applicationState.temperature = tc74.readTemperature();

	  // rtc
	  RTC_DateTypeDef date;
	  HAL_RTC_GetTime(&hrtc, &applicationState.time, RTC_FORMAT_BIN);
	  HAL_RTC_GetDate(&hrtc, &date, RTC_FORMAT_BIN);
/*

	  // Encoder
	  if (HAL_GPIO_ReadPin(Encoder_Switch_GPIO_Port, Encoder_Switch_Pin) == GPIO_PIN_RESET) {
		  ssd1306_SetCursor(2, 56);
		  ssd1306_WriteString("Enc Down", Font_6x8, White);
	  } else {
		  ssd1306_SetCursor(2, 56);
		  ssd1306_WriteString("Enc Up  ", Font_6x8, White);
	  }

	  ssd1306_SetCursor(50, 56);
	  sprintf(stringBuff, "Enc: %lu   ", TIM3->CNT);
	  ssd1306_WriteString(stringBuff, Font_6x8, White);

	  HAL_DAC_SetValue(&hdac,DAC_CHANNEL_1,DAC_ALIGN_12B_R,TIM3->CNT * 10);
*/
	  HAL_Delay(500);
  }
  /* USER CODE END 3 */
}

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
