jakubprzybytek/ActiveLoad/STM32CubeIDE/ActiveLoadBigMosfets/ActiveLoadBigMosfets.ioc

Mcu.UserName=STM32L151RDTx
PA10.GPIO_Label=TouchPad Reset
PA10.Signal=GPIO_Output
PA11.GPIO_Label=TouchPad Interrupt
PA11.Signal=GPXTI11
PA12.GPIO_Label=Display LED Ctrl
PA12.Signal=GPIO_Output
PA15.GPIO_Label=Display Reset
PA15.Signal=GPIO_Output
PA4.GPIO_Label=LoadLevel
PA4.Signal=COMP_DAC1_group
PA5.GPIO_Label=Fan PWM
PA5.Signal=S_TIM2_CH1_ETR
PA6.GPIO_Label=Encoder A
PA6.Signal=S_TIM3_CH1
PA7.GPIO_Label=Encoder B
PA7.Signal=S_TIM3_CH2
PA8.GPIO_Label=Encoder Switch
PA8.Signal=GPXTI8
PB10.Signal=I2C2_SCL
PB11.Signal=I2C2_SDA
PB12.GPIO_Label=LED
PB12.Signal=GPIO_Output
PB13.GPIO_Label=Load Op Amps Ctrl
PB13.Signal=GPIO_Output
PB14.GPIO_Label=Fan Power Ctrl
PB14.Signal=GPIO_Output
PB5.GPIO_Label=Display Read
PB5.Signal=GPIO_Output
PB6.GPIO_Label=Display Write
PB6.Signal=GPIO_Output
PB7.GPIO_Label=Display Data Command
PB7.Signal=GPIO_Output
PB8.GPIO_Label=Display Select
PB8.Signal=GPIO_Output
PB9.GPIO_Label=Fan Sensor
PB9.Signal=GPXTI9
PC0.Signal=GPIO_Output
PC1.Signal=GPIO_Output
PC10.Signal=GPIO_Output
PC11.Signal=GPIO_Output
PC12.Signal=GPIO_Output
PC13-WKUP2.Signal=GPIO_Output
PC14-OSC32_IN.Signal=GPIO_Output
PC15-OSC32_OUT.Signal=GPIO_Output
PC2.Signal=GPIO_Output
PC3.Signal=GPIO_Output
PC4.Signal=GPIO_Output
PC5.Signal=GPIO_Output
PC6.Signal=GPIO_Output
PC7.Signal=GPIO_Output
PC8.Signal=GPIO_Output
PC9.Signal=GPIO_Output
PH0-OSC_IN.Signal=RCC_OSC_IN
PH1-OSC_OUT.Signal=RCC_OSC_OUT
