jakubprzybytek/ActiveLoad/AtmelStudio/ActiveLoad/ActiveLoad.h

/*
 * ActiveLoad.h
 *
 * Created: 2018-04-17 19:50:11
 *  Author: Rodos
 */ 


#ifndef ACTIVELOAD_H_
#define ACTIVELOAD_H_

void processSwitchInterrupt();
void processTimerInterrupt();

#endif /* ACTIVELOAD_H_ */
