jakubprzybytek/ActiveLoad/AtmelStudio/ActiveLoadMosfets/Peripheral/ADC.h

/*
 * ADC.h
 *
 * Created: 2018-04-21 19:45:22
 *  Author: Rodos
 */ 

#ifndef ADC_H_
#define ADC_H_

#include <avr/io.h>

#define ADC11 ADC_CH_MUXPOS3_bm | ADC_CH_MUXPOS1_bm | ADC_CH_MUXPOS0_bm
#define ADC12 ADC_CH_MUXPOS3_bm | ADC_CH_MUXPOS2_bm

class ADC {
	
public:
	void init();

	void setInput(uint8_t input);
	void start();

	uint16_t readCH0();
	
};

#endif /* ADC_H_ */
