jakubprzybytek/ActiveLoad/(commit log)

2018-03-27 Finishing touches
    [ActiveLoad.kicad_pcb, _saved_ActiveLoad.sch]
2018-04-04 Diodes around 7812 added
    [ActiveLoad.kicad_pcb, ActiveLoad.sch, _saved_ActiveLoad.sch]
2018-04-05 Pad sizes fixed
    [ActiveLoad.kicad_pcb]
2018-04-17 Encoder support added
2018-04-18 Temperature reading from TC74
2018-05-13 Brand new version
    [ActiveLoad.kicad_pcb, ActiveLoad.sch]
2018-05-27 Current metter added
    [ActiveLoad.sch]
2018-05-30 More code around ADC and DAC
    [_saved_ActiveLoad.sch]
2018-06-03 Some fan control code
    [ActiveLoad.sch, _saved_ActiveLoad.sch]
2018-07-14 Auto fan and calibration
2018-08-15 ActiveLoad with mosfets added
    [ActiveLoad-2018-08-14-21-14-27.sch, ActiveLoad.kicad_pcb, ActiveLoad.sch, ActiveLoadMosfets.kicad_pcb, ActiveLoadMosfets.sch]
2018-08-15 PCB init
    [ActiveLoadMosfets.kicad_pcb, ActiveLoadMosfets.sch]
2018-08-18 pcb work
    [ActiveLoadMosfets.kicad_pcb, ActiveLoadMosfets.sch]
2018-08-18 More pcb work
    [ActiveLoadMosfets.kicad_pcb, ActiveLoadMosfets.sch]
2018-08-20 PCB Proofed
    [ActiveLoadMosfets.kicad_pcb, ActiveLoadMosfets.sch]
2018-08-21 PCB proofing
    [ActiveLoadMosfets.kicad_pcb]
2018-08-23 Some fixes
    [ActiveLoadMosfets.kicad_pcb]
2018-09-09 New Atmel Studio project for ActiveLoadMosfets
    [ActiveLoadMosfets.kicad_pcb, _saved_ActiveLoadMosfets.sch]
2018-09-17 More c++ code, bug fixes on the PCB
    [ActiveLoadMosfets.kicad_pcb, ActiveLoadMosfets.sch, _saved_ActiveLoadMosfets.sch]
2018-09-21 BCB fixes and cpp code mostly done
    [ActiveLoadMosfets.kicad_pcb, ActiveLoadMosfets.sch]
2020-03-17 major schematic work
    [ActiveLoadBigMosfets.kicad_pcb, ActiveLoadBigMosfets.sch, ActiveLoadMosfets.sch]
2020-04-27 Latest PCB changes. STM32 Project
    [ActiveLoadBigMosfets.kicad_pcb, ActiveLoadBigMosfets.sch]
2020-05-09 Display sample code
2020-05-10 TouchGFX init
    [ActiveLoadBigMosfets Debug.cfg, texts.xlsx]
2020-05-10 Voltage and current readouts added to gui
    [texts.xlsx]
2020-05-10 More work on gui
    [texts.xlsx]
2020-05-11 Fan duty cycle added to gui
    [texts.xlsx]
2020-05-12 Tweaks in gui
    [ActiveLoadBigMosfets Debug.cfg, texts.xlsx]
2020-05-15 Fan controller added
    [ActiveLoadBigMosfets.sch]
2020-05-16 Initial touch pad code
    [texts.xlsx]
2020-05-17 More interactions in gui
    [texts.xlsx]
2020-05-17 CPU set to 32MHz, RTC set up to use HSE
    [texts.xlsx]
2020-05-31 Fan RPM measurement added
    [ActiveLoadBigMosfets.sch, texts.xlsx]
2020-06-01 Better encoder control. Can be used for current limit.
    [texts.xlsx]
2020-06-03 Voltage limit can now be edited
    [texts.xlsx]
2020-06-05 PID controller added for load
    [texts.xlsx]
2020-06-05 PID for fan controller
    [texts.xlsx]
2020-06-06 Capacity counter implemented
    [texts.xlsx]
2020-06-11 Storing state in EEPROM
    [texts.xlsx]
2020-06-11 Start stop button
    [texts.xlsx]
2020-06-12 Silly hysteresis for fan controller
    [texts.xlsx]
2020-06-12 Small fixes around eeprom
    [ActiveLoad.cpp, EEPROM.cpp]
2020-06-14 Stop load when voltage limit finishes
2020-06-14 Voltage limit happens now every 500ms
2020-06-20 Voltage, current and power is now stored as integers
    [texts.xlsx]
2020-06-20 Timer reimplemented. Can be stopperd/started now
2020-06-20 Fan rpm fixed
2020-07-11 Debug screen added
    [ActiveLoadBigMosfets.kicad_pcb, ActiveLoadBigMosfets.sch, texts.xlsx]
2020-08-09 PCB fixes, increasing DM for LoadController
    [ActiveLoad.cpp, LoadController.cpp, TC74.cpp]
2020-08-10 Fan unlocked
